LGQWakkk/F405-PCB-FPV/description.txt

产品简介

	为尽可能降低穿越机入门成本以及降低炸鸡损失，以及对FR4这种板材富有弹性且足够轻巧的特性的极致利用，完全使用PCB作为飞机主体，并使用模块化设计的一款四旋翼飞行器。

应用场景

1.FPV飞行练习

2.Ardupilot Betaflight INAV等飞控飞行平台

3.科研使用小型飞行平台

产品概述

1.主要结构为4个电调机臂总成板、1个主结构板和1个飞控板。其中电调和飞控为四层板，主结构板位为2层板，所有板子尺寸均在10cmx10cm之内，都可以免费打样。

2.电调部分使用BlHeli固件，根据MOS选型的不同，支持20-30A的大电流。

3.电调支持2-3S电压输入。

4.对于F405飞控引出大部分外设接口，方便拓展功能，实现硬件最大化利用。

5.预留主动红外定位接口，方便实现四旋翼室内定位。

6.超低成本，单个电调元器件成本约为11￥

使用说明

	超级详细的采购、焊接、组装以及使用说明请见附件“F405集成飞行器焊接以及制作说明.pdf”。
