LGQWakkk/F405-PCB-FPV/images/WKESC-1.jpg

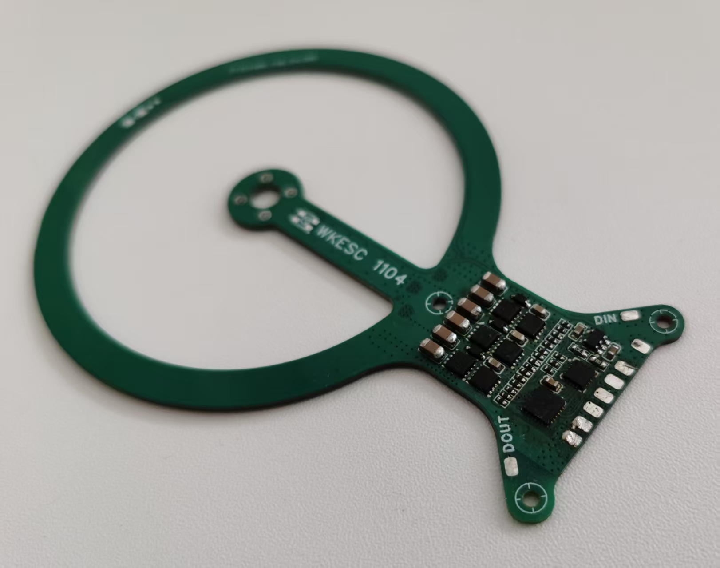
images/WKESC-1.jpg
