LGQWakkk/F405-PCB-FPV/images/WKESC-2.jpg

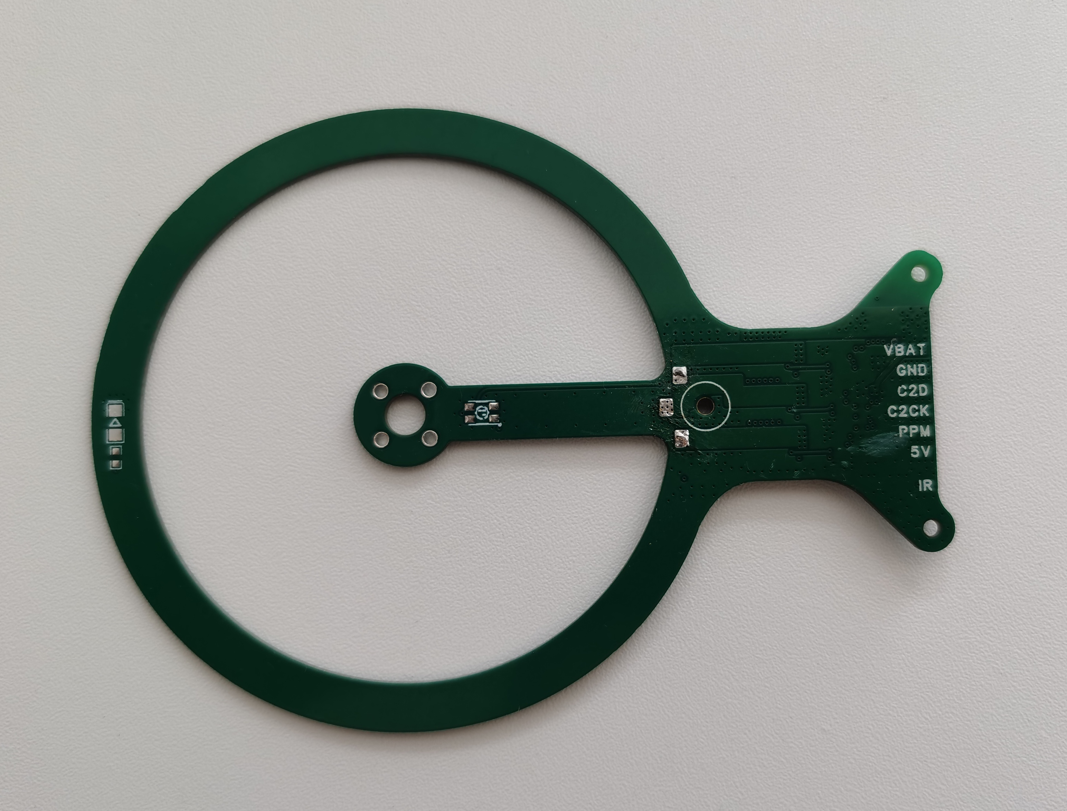
images/WKESC-2.jpg
