LGQWakkk/F405-PCB-FPV/images/WKESC-3.jpg

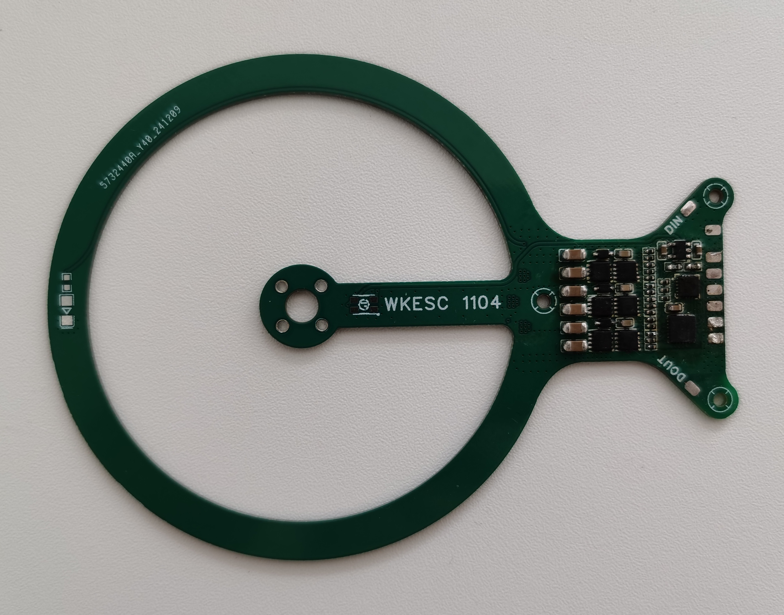
images/WKESC-3.jpg
