LGQWakkk/F405-PCB-FPV/ESC/BOM_Board1_Schematic1_2025-01-20.xlsx

No. | Quantity | Comment | Designator | Footprint | Value | Manufacturer Part | Manufacturer | Supplier Part | Supplier
1 | 2 | 10uF | C6,C75 | C0603 | 10uF | CL10A106KP8NNNC | SAMSUNG(三星) | C19702 | LCSC
2 | 1 | 100nF | C34 | C0603 | 100nF | CC0603KRX7R9BB104 | YAGEO(国巨) | C14663 | LCSC
3 | 6 | 22uF | C45,C73,C74,C79,C80,C81 | C0805 | 22uF | CL21A226MAQNNNE | SAMSUNG(三星) | C45783 | LCSC
4 | 3 | 10uF | C76,C77,C78 | C0603 | 10uF | CL10A106MA8NRNC | SAMSUNG(三星) | C96446 | LCSC
5 | 3 | 1N5819WS | D10,D11,D12 | SOD-323_L1.8-W1.3-LS2.5-RD |  | 1N5819WS | Hottech(合科泰) | C191023 | LCSC
6 | 2 | XL-3216SURC | LED1,LED2 | LED1206-R-RD_RED |  | XL-3216SURC | XINGLIGHT(成兴光) | C965822 | LCSC
7 | 2 | XL-3528RGBW-WS2812B | LED3,LED4 | LED-SMD_4P-L3.5-W2.8-BR-1 |  | XL-3528RGBW-WS2812B | XINGLIGHT(成兴光) | C2890364 | LCSC
8 | 6 | TPN2R203NC,L1Q(M | Q7,Q8,Q9,Q10,Q11,Q12 | TSON-8_L3.1-W3.1-P0.65-LS3.3-BL-EP |  | TPN2R203NC,L1Q(M | TOSHIBA(东芝) | C471286 | LCSC
9 | 6 | 10Ω | R62,R63,R64,R65,R66,R67 | R0402 | 10Ω | 0402WGF100JTCE | UNI-ROYAL(厚声) | C25077 | LCSC
10 | 6 | 10kΩ | R68,R69,R70,R71,R72,R73 | R0402 | 10kΩ | 0402WGF1002TCE | UNI-ROYAL(厚声) | C25744 | LCSC
11 | 6 | 1kΩ | R74,R75,R76,R77,R78,R79 | R0402 | 1kΩ | 0402WGF1001TCE | UNI-ROYAL(厚声) | C11702 | LCSC
12 | 1 | 1kΩ | R82 | R0603 | 1kΩ | 0603WAF1001T5E | UNI-ROYAL(厚声) | C21190 | LCSC
13 | 1 | 10kΩ | R83 | R0603 | 10kΩ | 0603WAF1002T5E | UNI-ROYAL(厚声) | C25804 | LCSC
14 | 2 | 100Ω | R84,R85 | R0603 | 100Ω | 0603WAF1000T5E | UNI-ROYAL(厚声) | C22775 | LCSC
15 | 3 | M2螺丝 | SCREW1,SCREW2,SCREW3 | M2螺丝
16 | 1 | EFM8BB21F16G-C-QFN20R | U2 | QFN-20_L3.0-W3.0-P0.50-BL-EP1.7_EFM8BB21F16G |  | EFM8BB21F16G-C-QFN20R | SKYWORKS/SILICON LABS(芯科) | C80713 | LCSC
17 | 1 | ME6217C33M5G | U79 | SOT-23-5_L3.0-W1.7-P0.95-LS2.8-BR |  | ME6217C33M5G | MICRONE(南京微盟) | C427602 | LCSC
18 | 1 | FD6288Q | U82 | QFN-24_L4.0-W4.0-P0.50-BL-EP2.6 |  | FD6288Q | Fortior Tech(峰岹) | C328453 | LCSC
19 | 1 | 6pin焊接引出 | U83 | 6pin焊接引出
20 | 3 | 1pin焊接引出 | U85,U86,U87 | 1pin焊接引出
