LGQWakkk/F405-PCB-FPV/F405/BOM_Board1_Schematic1_2025-01-20.xlsx

No. | Quantity | Comment | Designator | Footprint | Value | Manufacturer Part | Manufacturer | Supplier Part | Supplier
1 | 4 | 10uF | C8,C53,C63,C69 | C0603 | 10uF | CL10A106KP8NNNC | SAMSUNG(三星) | C19702 | LCSC
2 | 2 | 30pF | C9,C42 | C0603 | 30pF | 0603CG300J500NT | FH(风华) | C1658 | LCSC
3 | 11 | 100nF | C12,C13,C14,C15,C16,C17,C40,C41,C51,C52,C68 | C0603 | 100nF | CC0603KRX7R9BB104 | YAGEO(国巨) | C14663 | LCSC
4 | 2 | 2.2uF | C20,C21 | C0603 | 2.2uF | CL10A225KO8NNNC | SAMSUNG(三星) | C23630 | LCSC
5 | 1 | TF-021B-H265 | CARD1 | TF-SMD_TF-021B-H265 |  | TF-021B-H265 | SOFNG(硕方) | C498185 | LCSC
6 | 2 | KT-0603R | LED1,LED2 | LED0603-RD |  | KT-0603R | KENTO | C2286 | LCSC
7 | 2 | S8050 | Q1,Q2 | SOT-23-3_L2.9-W1.3-P1.90-LS2.4-BR |  | S8050 | YONGYUTAI(永裕泰) | C2891804 | LCSC
8 | 5 | 1kΩ | R15,R27,R42,R43,R45 | R0603 | 1kΩ | 0603WAF1001T5E | UNI-ROYAL(厚声) | C21190 | LCSC
9 | 7 | 10kΩ | R20,R25,R26,R28,R29,R32,R33 | R0603 | 10kΩ | 0603WAF1002T5E | UNI-ROYAL(厚声) | C25804 | LCSC
10 | 2 | 22Ω | R30,R34 | R0603 | 22Ω | 0603WAF220JT5E | UNI-ROYAL(厚声) | C23345 | LCSC
11 | 1 | 100Ω | R35 | R0603 | 100Ω | 0603WAF1000T5E | UNI-ROYAL(厚声) | C22775 | LCSC
12 | 2 | 47kΩ | R40,R41 | R0603 | 47kΩ | 0603WAF4702T5E | UNI-ROYAL(厚声) | C25819 | LCSC
13 | 2 | 5.1kΩ | R46,R47 | R0603 | 5.1kΩ | 0603WAF5101T5E | UNI-ROYAL(厚声) | C23186 | LCSC
14 | 4 | M3螺丝 | SCREW1,SCREW2,SCREW3,SCREW4 | M3螺丝
15 | 2 | TS342A2P-WZ | SW1,SW2 | SW-SMD_L4.0-W2.9-LS5.0 |  | TS342A2P-WZ | SHOU HAN(首韩) | C557591 | LCSC
16 | 1 | STM32F405RGT6 | U5 | LQFP-64_L10.0-W10.0-P0.50-LS12.0-BL |  | STM32F405RGT6 | ST(意法半导体) | C15742 | LCSC
17 | 1 | ME6217C33M5G | U31 | SOT-23-5_L3.0-W1.7-P0.95-LS2.8-BR |  | ME6217C33M5G | MICRONE(南京微盟) | C427602 | LCSC
18 | 1 | LSM6DS3TR | U34 | LGA-14_L3.0-W2.5-P0.50-TL |  | LSM6DS3TR | ST(意法半导体) | C95230 | LCSC
19 | 1 | SPL06-001 | U79 | SENSOR-SMD_SPL06-001 |  | SPL06-001 | Goertek(歌尔) | C2684428 | LCSC
20 | 4 | 6pin焊接引出 | U83,U84,U86,U87 | 6pin焊接引出
21 | 1 | TYPE-C-31-D-09 | U89 | USB-C-TH_TYPE-C-31-D-09 |  | TYPE-C-31-D-09 | 韩国韩荣 | C7463258 | LCSC
22 | 5 | 1pin焊接引出 | U90,U91,U92,U93,U94 | 1pin焊接引出
23 | 1 | 12MHz | X3 | CRYSTAL-SMD_4P-L3.2-W2.5-BL | 12MHz | X322512MSB4SI | YXC(扬兴晶振) | C9002 | LCSC
