LGQWakkk/F405-PCB-FPV/MAINBOARD/BOM_Board1_Schematic1_2025-01-20.xlsx

No. | Quantity | Comment | Designator | Footprint | Value | Manufacturer Part | Manufacturer | Supplier Part | Supplier
1 | 4 | 6pin焊接引出 | U1,U2,U3,U4 | 6pin焊接引出
2 | 2 | 表面焊盘 | U93,U94 | 表面焊盘
3 | 1 | DCDC-5V | U95 | DCDC5V不带直插排针焊盘
