LGQWakkk/F405-PCB-FPV/F405/SCH_Schematic1_2025-01-20.pdf

# ADC SENSE

# STM32F405RGT6

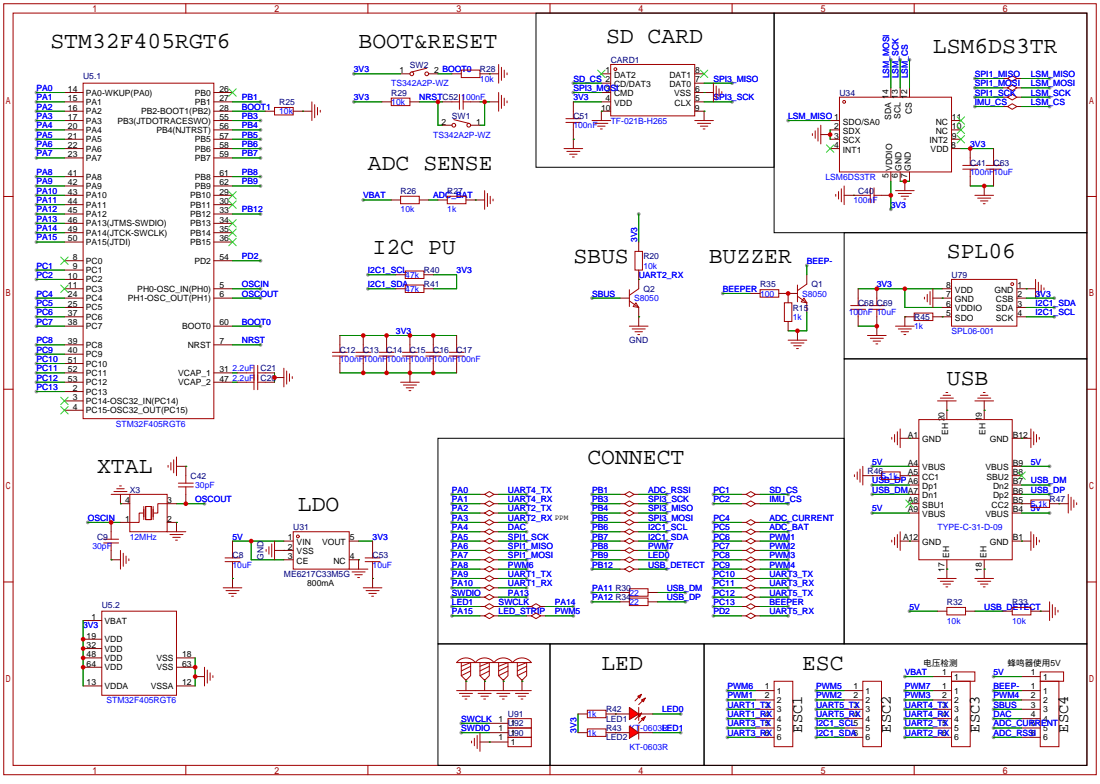
[picture p6: page 1]
