LGQWakkk/F405-PCB-FPV/MAINBOARD/SCH_Schematic1_2025-01-20.pdf

# ESC&PWM

# DCDC

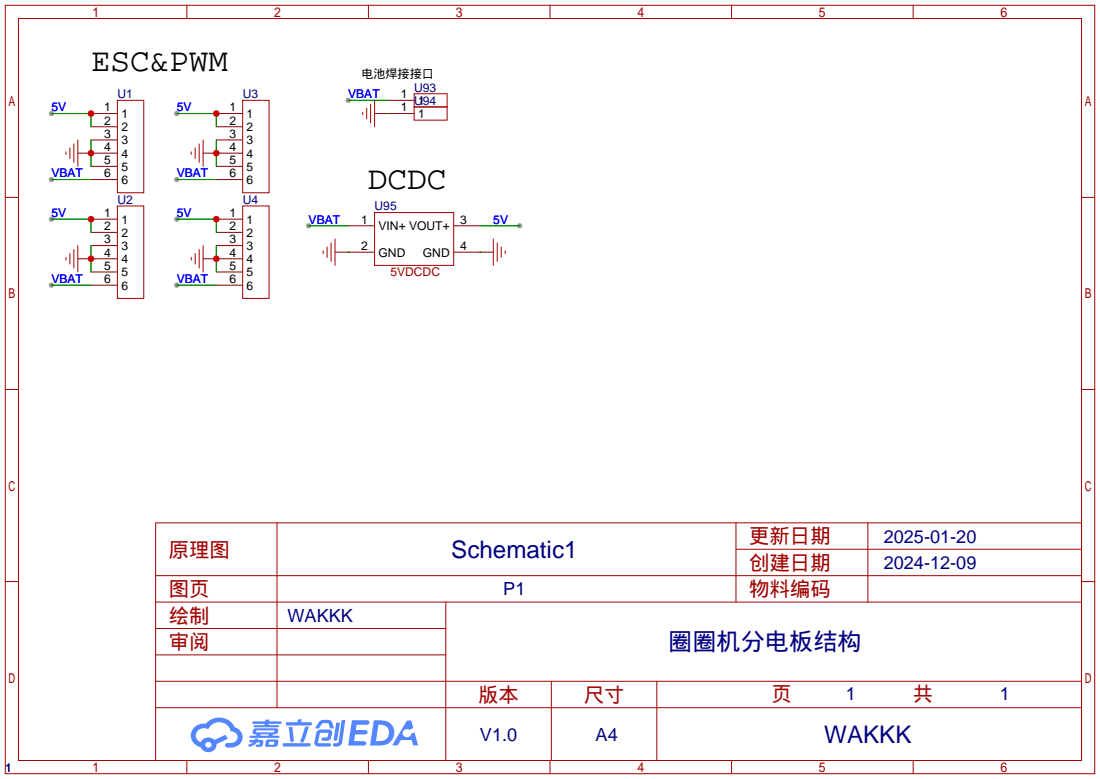
[picture p7: page 1]
