LGQWakkk/F405-PCB-FPV/ESC/SCH_Schematic1_2025-01-20.pdf

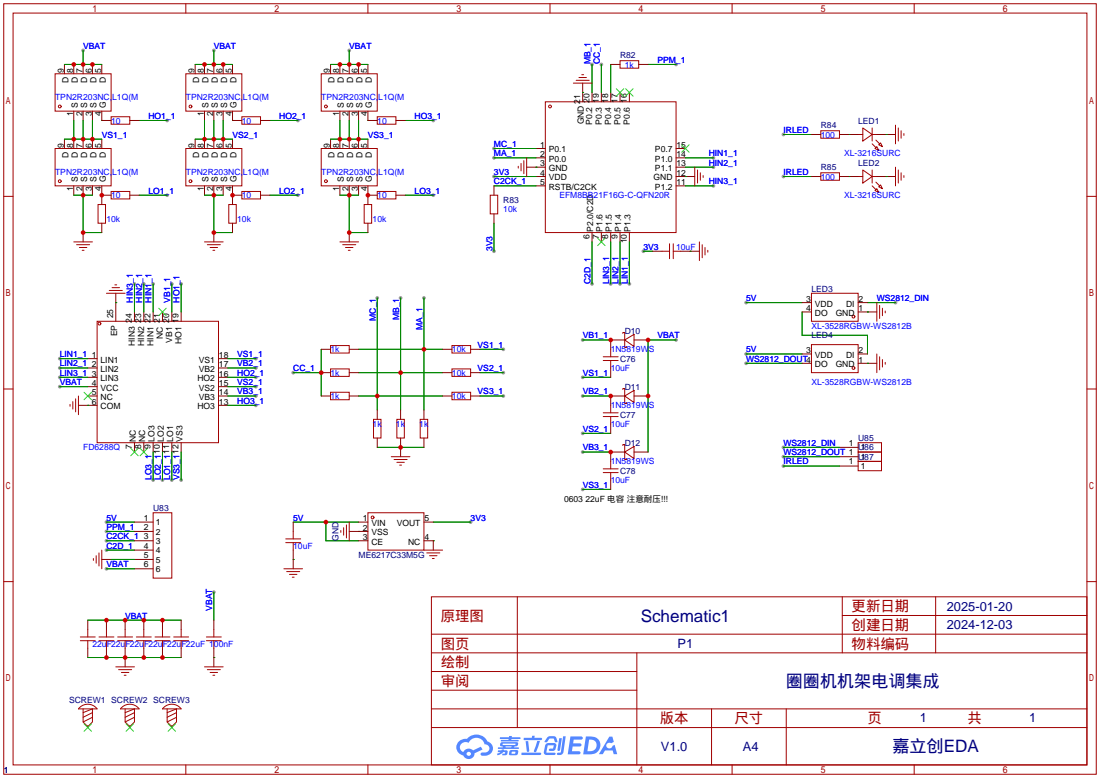
[picture p8: page 1]
