LGQWakkk/F405-PCB-FPV/(list of files, drawings)

Other design files:
Projects/ESC.epro
Projects/F405.epro
Projects/MAINBOARD.epro
